Ape3Diana/CPU8086/SSD.vhd

----------------------------------------------------------------------------------
-- Company: Technical University of Cluj-Napoca 
-- Engineer: Cristian Vancea
-- 
-- Module Name: SSD - Behavioral
-- Description: 
--      Display on SSD Unit
----------------------------------------------------------------------------------

library IEEE;
use IEEE.STD_LOGIC_1164.ALL;
use IEEE.STD_LOGIC_UNSIGNED.ALL;

entity SSD is
    Port ( clk : in STD_LOGIC;
           digits : in STD_LOGIC_VECTOR(15 downto 0);
           an : out STD_LOGIC_VECTOR(7 downto 0);
           cat : out STD_LOGIC_VECTOR(6 downto 0));
end SSD;

architecture Behavioral of SSD is

signal digit : STD_LOGIC_VECTOR(3 downto 0);
signal cnt : STD_LOGIC_VECTOR(16 downto 0) := (others => '0');
signal sel : STD_LOGIC_VECTOR(1 downto 0);

begin

    counter : process(clk) 
    begin
        if rising_edge(clk) then
            cnt <= cnt + 1;
        end if;
    end process;

    sel <= cnt(15 downto 14);

    muxCat : process(sel, digits)
    begin
        case sel is
            when "00"   => digit <= digits(3 downto 0);   -- Digit 0 (LS Nibble)
            when "01"   => digit <= digits(7 downto 4);   -- Digit 1
            when "10"   => digit <= digits(11 downto 8);  -- Digit 2
            when "11"   => digit <= digits(15 downto 12); -- Digit 3 (MS Nibble)
            when others => digit <= (others => 'X');
        end case;
    end process;

    muxAn : process(sel)
    begin
        case sel is
            when "00"   => an <= "11111110"; -- Activate AN0
            when "01"   => an <= "11111101"; -- Activate AN1
            when "10"   => an <= "11111011"; -- Activate AN2
            when "11"   => an <= "11110111"; -- Activate AN3
            when others => an <= "11111111"; -- All anodes off if error
        end case;
    end process;

    with digit SELect
        cat <= "1000000" when "0000",   -- 0
               "1111001" when "0001",   -- 1
               "0100100" when "0010",   -- 2
               "0110000" when "0011",   -- 3
               "0011001" when "0100",   -- 4
               "0010010" when "0101",   -- 5
               "0000010" when "0110",   -- 6
               "1111000" when "0111",   -- 7
               "0000000" when "1000",   -- 8
               "0010000" when "1001",   -- 9
               "0001000" when "1010",   -- A
               "0000011" when "1011",   -- b
               "1000110" when "1100",   -- C
               "0100001" when "1101",   -- d
               "0000110" when "1110",   -- E
               "0001110" when "1111",   -- F
               (others => 'X') when others;

end Behavioral;
